gannoCal/Accelerometer-Angle-Acquisition-and-Subsequent-Display-in-MATLAB/README.txt

EX_ADC is the project folder.

serialtest.m is the MATLAB code to live demo serial values.

Youtube demo found at https://www.youtube.com/watch?v=DiozCoiJ9sk

2DP4FinalProject_400137271.pdf is the project report.

Gannonc
400137271
