gannoCal/Accelerometer-Angle-Acquisition-and-Subsequent-Display-in-MATLAB/(notices)

Notices in the files:
EX_ADC/Sources/SCI.C:
Copyright 2006 by Jonathan W. Valvano, valvano@mail.utexas.edu
